sssssaud/classroom-ecosystem/Screenshot_20260919_154007.png

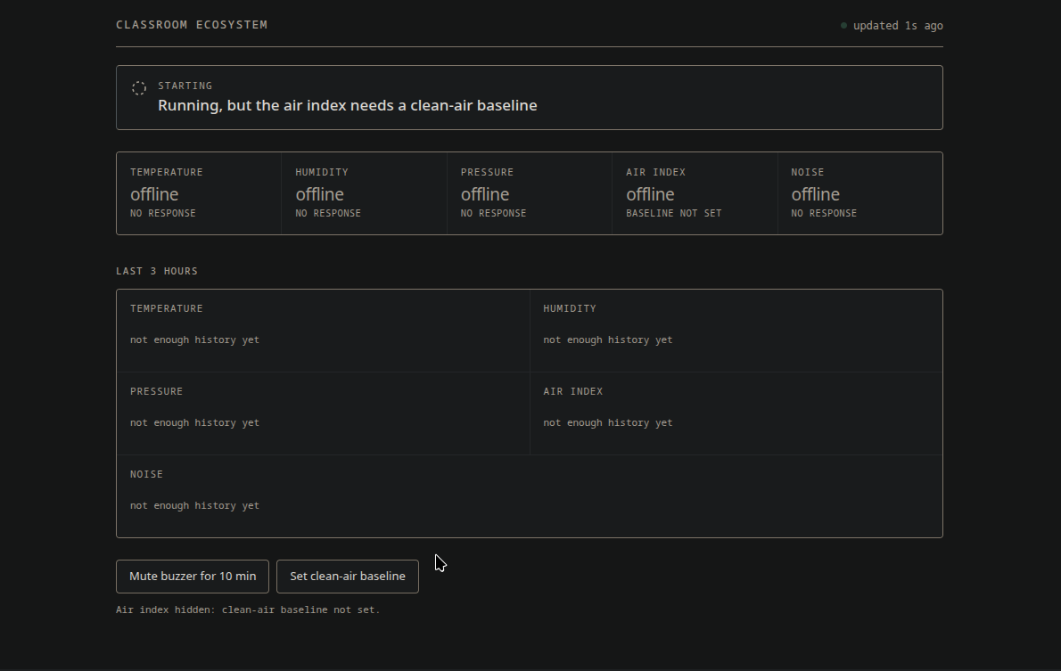
Screenshot_20260919_154007.png
