sssssaud/classroom-ecosystem/firmware/classroom_node/sensors.cpp

#include "sensors.h"

#include <Arduino.h>
#include <Wire.h>
#include <Preferences.h>
#include <Adafruit_BME280.h>
#include <Adafruit_BMP280.h>
#include <ESP_I2S.h>
#include <math.h>

#include "config.h"

namespace {

Adafruit_BME280 bme;
bool bme_ok = false;

Adafruit_BMP280 bmp;   // same footprint and addresses, no humidity die
bool bmp_ok = false;

I2SClass i2s;
bool i2s_ok = false;

Preferences prefs;
float r0_ = 0.0f;              // clean-air resistance; 0 means "never calibrated"
float rs_ema_ = 0.0f;
bool  rs_primed_ = false;

uint32_t cal_until_ms_ = 0;
double   cal_sum_ = 0.0;
uint32_t cal_n_ = 0;

// Raw sensor resistance from one ADC read, before any compensation.
// Returns 0 on an implausible reading so the caller can mark the channel dead.
float readRs() {
  const int adc = analogRead(PIN_MQ135_AO);
  const float v_node = (float(adc) / ADC_MAX) * ADC_REF_V;
  const float v_ao = v_node * (MQ_DIVIDER_R1 + MQ_DIVIDER_R2) / MQ_DIVIDER_R2;
  // At the rails the divider maths blows up (or goes negative), and a floating
  // ADC pin sits near 0. Either way we have no usable resistance.
  if (v_ao < 0.05f || v_ao >= MQ_VCC - 0.05f) return 0.0f;
  return MQ_LOAD_R * (MQ_VCC - v_ao) / v_ao;
}

// MQ sensors read lower when warm and humid. First-order correction only.
float compensate(float rs, const Reading& temp, const Reading& hum) {
  float k = 1.0f;
  if (temp.valid) k += MQ_TEMP_COEFF * (temp.value - 20.0f);
  if (hum.valid)  k += MQ_HUM_COEFF * (hum.value - 50.0f);
  if (k < 0.2f) k = 0.2f;   // never let the correction invert the reading
  return rs / k;
}

bool readNoiseDb(float& db) {
  if (!i2s_ok) return false;

  static int32_t buf[I2S_FRAMES];
  const size_t want = sizeof(buf);
  const size_t got = i2s.readBytes(reinterpret_cast<char*>(buf), want);
  const size_t n = got / sizeof(int32_t);
  if (n < 32) return false;

  // INMP441 sends 24-bit samples left-aligned in a 32-bit slot, with a DC
  // offset that would otherwise dominate the RMS.
  double sum = 0.0;
  for (size_t i = 0; i < n; ++i) sum += double(buf[i] >> 8);
  const double mean = sum / double(n);

  double sq = 0.0;
  for (size_t i = 0; i < n; ++i) {
    const double s = double(buf[i] >> 8) - mean;
    sq += s * s;
  }
  const double rms = sqrt(sq / double(n));
  // Perfect digital silence means the mic is not clocking data at all, which
  // in practice means it is unwired. Reporting a dB number for that invents one.
  if (rms < 1.0) return false;

  db = float(20.0 * log10(rms / 8388608.0)) + NOISE_DB_OFFSET;
  return true;
}

}  // namespace

// True if anything at all answers on this pin order.
static bool busHasDevices(int sda, int scl) {
  Wire.end();
  Wire.begin(sda, scl);
  Wire.setClock(100000);          // long dupont wires are marginal at 400 kHz
  for (uint8_t a = 1; a < 127; ++a) {
    Wire.beginTransmission(a);
    if (Wire.endTransmission() == 0) return true;
  }
  return false;
}

bool sensorsBegin() {
  // SDA/SCL are easy to cross on a breadboard, and a crossed pair looks exactly
  // like a dead sensor. Try the wired order, then the other one.
  if (!busHasDevices(PIN_I2C_SDA, PIN_I2C_SCL)) {
    if (busHasDevices(PIN_I2C_SCL, PIN_I2C_SDA)) {
      Serial.println("I2C: nothing on the wired order, using SDA/SCL swapped");
    } else {
      Wire.end();
      Wire.begin(PIN_I2C_SDA, PIN_I2C_SCL);
    }
  }

  // Print whatever is actually on the bus. "Not found" on its own cannot tell
  // a miswired sensor from one sitting at an address we never tried.
  Serial.print("I2C scan:");
  uint8_t seen = 0;
  for (uint8_t addr = 1; addr < 127; ++addr) {
    Wire.beginTransmission(addr);
    if (Wire.endTransmission() == 0) {
      Serial.printf(" 0x%02X", addr);
      ++seen;
    }
  }
  Serial.println(seen ? "" : " nothing responded (check SDA/SCL/VCC/GND)");

  // Breakouts ship on either address; probe both rather than make the user care.
  bme_ok = bme.begin(0x76, &Wire) || bme.begin(0x77, &Wire);
  if (bme_ok) {
    bme.setSampling(Adafruit_BME280::MODE_FORCED,
                    Adafruit_BME280::SAMPLING_X1,   // temperature
                    Adafruit_BME280::SAMPLING_X1,   // pressure
                    Adafruit_BME280::SAMPLING_X1,   // humidity
                    Adafruit_BME280::FILTER_OFF);
    Serial.println("BME280 found: temperature, humidity and pressure are real");
  } else {
    // Boards sold as "BME280" are very often BMP280: same footprint, same
    // addresses, no humidity die inside. Use it for what it does have.
    bmp_ok = bmp.begin(0x76, BMP280_CHIPID) || bmp.begin(0x77, BMP280_CHIPID);
    if (bmp_ok) {
      bmp.setSampling(Adafruit_BMP280::MODE_FORCED,
                      Adafruit_BMP280::SAMPLING_X1,   // temperature
                      Adafruit_BMP280::SAMPLING_X1,   // pressure
                      Adafruit_BMP280::FILTER_OFF);
      Serial.println("BMP280 found: temperature and pressure real, NO humidity sensor");
    } else {
      Serial.println("No BME/BMP280 on the bus: comfort channel is simulated");
    }
  }

  analogSetPinAttenuation(PIN_MQ135_AO, ADC_11db);

  // Which slot the INMP441 speaks on depends on how its L/R pin is strapped,
  // and a mismatch reads as perfect silence rather than as an error. Test both
  // slots and pick the one with real audio signal (RMS > 1.0).
  i2s_ok = false;
  double best_rms = 0.0;
  i2s_std_slot_mask_t best_slot = I2S_STD_SLOT_RIGHT;

  for (uint8_t attempt = 0; attempt < 2; ++attempt) {
    // Probe RIGHT first since L/R is tied high on this build, then LEFT
    const i2s_std_slot_mask_t slot = (attempt == 0) ? I2S_STD_SLOT_RIGHT : I2S_STD_SLOT_LEFT;
    i2s.end();
    delay(30);
    i2s.setPins(PIN_I2S_BCLK, PIN_I2S_WS, -1, PIN_I2S_DIN, -1);
    if (!i2s.begin(I2S_MODE_STD, I2S_SAMPLE_RATE, I2S_DATA_BIT_WIDTH_32BIT,
                   I2S_SLOT_MODE_MONO, slot)) {
      continue;
    }
    static int32_t probe[256];
    i2s.readBytes(reinterpret_cast<char*>(probe), sizeof(probe));   // flush/settle
    delay(30);
    const size_t n = i2s.readBytes(reinterpret_cast<char*>(probe), sizeof(probe))
                     / sizeof(int32_t);
    if (n < 32) continue;

    double sum = 0.0;
    for (size_t i = 0; i < n; ++i) sum += double(probe[i] >> 8);
    const double mean = sum / double(n);

    double sq = 0.0;
    for (size_t i = 0; i < n; ++i) {
      const double s = double(probe[i] >> 8) - mean;
      sq += s * s;
    }
    const double rms = sqrt(sq / double(n));
    if (rms > best_rms) {
      best_rms = rms;
      best_slot = slot;
    }
  }

  if (best_rms >= 1.0) {
    i2s.end();
    delay(30);
    i2s.setPins(PIN_I2S_BCLK, PIN_I2S_WS, -1, PIN_I2S_DIN, -1);
    i2s.begin(I2S_MODE_STD, I2S_SAMPLE_RATE, I2S_DATA_BIT_WIDTH_32BIT,
              I2S_SLOT_MODE_MONO, best_slot);
    i2s_ok = true;
    Serial.printf("I2S: mic found on %s slot (rms=%.1f)\n",
                  (best_slot == I2S_STD_SLOT_RIGHT) ? "RIGHT" : "LEFT", best_rms);
  } else {
    i2s.end();
    Serial.println("I2S: no mic data on either slot (check SD/GPIO33)");
  }

  prefs.begin("classroom", false);
  r0_ = prefs.getFloat("mq_r0", 0.0f);

  return bme_ok;
}

// Two periods that do not divide each other, so the trace drifts like a room
// rather than tracing a textbook sine wave.
static float drift(uint32_t now_ms, float centre, float span,
                   uint32_t period_s, uint32_t phase_s) {
  const float w = 2.0f * 3.14159265f / (float(period_s) * 1000.0f);
  const float t = float(now_ms) + float(phase_s) * 1000.0f;
  return centre + span * (0.72f * sinf(w * t) + 0.28f * sinf(w * t * 4.3f));
}

// Which channels carry synthetic values. Humidity needs the BME280's extra
// die, so a BMP280 can never supply it however well it is wired.
bool channelSimulated(ReadingId id) {
  if (id == R_HUM) return !bme_ok;
  if (id == R_TEMP || id == R_PRESS) return !bme_ok && !bmp_ok;
  return false;
}

bool anySimulated() { return !bme_ok; }

void sensorsRead(Readings& out, uint32_t now_ms) {
  // ---- BME280 ----
  if (bme_ok) {
    if (bme.takeForcedMeasurement()) {
      const float t = bme.readTemperature();
      const float h = bme.readHumidity();
      const float p = bme.readPressure() / 100.0f;
      // A disconnected BME280 reads back as NaN rather than failing loudly.
      out.v[R_TEMP]  = { t, !isnan(t) };
      out.v[R_HUM]   = { h, !isnan(h) };
      out.v[R_PRESS] = { p, !isnan(p) && p > 300.0f && p < 1100.0f };
    }
  } else if (bmp_ok) {
    if (bmp.takeForcedMeasurement()) {
      const float t = bmp.readTemperature();
      const float p = bmp.readPressure() / 100.0f;
      out.v[R_TEMP]  = { t, !isnan(t) };
      out.v[R_PRESS] = { p, !isnan(p) && p > 300.0f && p < 1100.0f };
    }
    // This chip has no humidity die, so that one channel stays synthetic.
    // channelSimulated() labels it all the way to the dashboard.
    out.v[R_HUM] = { drift(now_ms, 52.0f, 7.0f, 660, 90), true };
  } else {
    // Nothing answered on the bus, so the comfort channel runs on plausible
    // synthetic values instead of three dead tiles. Every path out of here
    // labels them, and the branch disappears when a real sensor answers at boot.
    out.v[R_TEMP]  = { drift(now_ms,   26.0f, 1.6f,  420,   0), true };
    out.v[R_HUM]   = { drift(now_ms,   52.0f, 7.0f,  660,  90), true };
    out.v[R_PRESS] = { drift(now_ms, 1011.0f, 2.2f, 1380, 200), true };
  }

  // ---- MQ-135 ----
  const float rs_raw = readRs();
  if (rs_raw > 0.0f) {
    const float rs = compensate(rs_raw, out.v[R_TEMP], out.v[R_HUM]);
    rs_ema_ = rs_primed_ ? (MQ_EMA_ALPHA * rs + (1.0f - MQ_EMA_ALPHA) * rs_ema_) : rs;
    rs_primed_ = true;

    if (calibrating(now_ms)) {
      cal_sum_ += rs;
      ++cal_n_;
    } else if (cal_n_ > 0) {                 // window just closed
      r0_ = float(cal_sum_ / double(cal_n_));
      Serial.printf("MQ: baseline closed, n=%u r0=%.0f\n", cal_n_, r0_);
      prefs.putFloat("mq_r0", r0_);
      cal_sum_ = 0.0;
      cal_n_ = 0;
    }

    // Index is R0/Rs: resistance falls as gas rises, so the number rises with
    // gas. 1.0 means "same as the clean air you calibrated in".
    // The sensor is not burned in: its clean-air resistance wanders several-fold
    // over hours. Let the baseline creep after it (tau ~20 min) so slow drift
    // never trips the alarm, while a gas puff -- seconds, not hours -- still does.
    // Not persisted: NVS would not survive a write every sample.
    if (r0_ > 0.0f && !calibrating(now_ms)) r0_ += (rs_ema_ - r0_) * MQ_R0_CREEP;

    if (r0_ > 0.0f && rs_ema_ > 0.0f) {
      out.v[R_AIR] = { r0_ / rs_ema_, true };
    }
  }

  // ---- INMP441 ----
  float db = 0.0f;
  if (readNoiseDb(db)) out.v[R_NOISE] = { db, true };
}

bool  baselineSet()  { return r0_ > 0.0f; }
// Raw baseline numbers on the API so the index can be debugged without serial.
float mqR0()         { return r0_; }
float mqRsEma()      { return rs_ema_; }
float baselineR0()   { return r0_; }

void startCalibration(uint32_t now_ms) {
  cal_until_ms_ = now_ms + CALIBRATE_MS;
  cal_sum_ = 0.0;
  cal_n_ = 0;
}

bool calibrating(uint32_t now_ms) {
  return int32_t(cal_until_ms_ - now_ms) > 0;
}

void clearBaseline() {
  r0_ = 0.0f;
  prefs.remove("mq_r0");
}
