sssssaud/classroom-ecosystem/firmware/classroom_node/sensors.h

// Hardware reads. Everything Arduino-specific lives behind this interface so
// status.cpp / history.cpp stay testable on the laptop.
#pragma once
#include <stdint.h>
#include "status.h"

// false means the BME280 never answered on either address; the node still runs
// and reports that channel offline rather than refusing to boot.
bool sensorsBegin();

// Fills every channel. Any sensor that fails sets valid=false — never 0.
void sensorsRead(Readings& out, uint32_t now_ms);

// True when this channel carries a synthetic value rather than a measurement.
// Callers must label it. A BMP280 supplies temperature and pressure but has no
// humidity die, so humidity stays synthetic even when that sensor is healthy.
bool channelSimulated(ReadingId id);
bool anySimulated();

// ---- MQ-135 clean-air baseline ----
bool  baselineSet();
float mqR0();
float mqRsEma();
float baselineR0();
void  startCalibration(uint32_t now_ms);
bool  calibrating(uint32_t now_ms);
void  clearBaseline();
