sssssaud/classroom-ecosystem/(commit log)

2026-09-19 Design spec and verified dashboard for the classroom monitor
    One ESP32 serving its own dashboard for a single classroom: BME280, MQ-135
    and INMP441 in, three status LEDs and a buzzer out.
    The dashboard is built and checked against a stdlib mock of the firmware's
    JSON, so the UI was settled with no hardware attached. No CDN and no chart
    library, because the ESP32 serves this page with no internet available.
    Two things the design refuses to fake: the MQ-135 reports a relative index
    against a user-set clean-air baseline rather than invented ppm, and a sensor
    that cannot be read renders as "offline" rather than as zero.
2026-09-19 Add ESP32 firmware: sensors, status engine, history, web server
    Sketch builds with arduino-cli for esp32:esp32:esp32 (81% flash, 19% RAM).
    - status/history stay pure C++ so they unit-test on the laptop; 10 host
    tests cover dwell, hysteresis release, mute, fault precedence and ring
    wrap (firmware/test/test_status.cpp).
    - sensors.cpp probes the BME280 at both addresses, derives the MQ-135
    index from a stored clean-air baseline, and reads the INMP441 over I2S.
    A dead channel reports invalid, never 0.
    - The dashboard is embedded from ui/index.html via tools/gen_page.py, so
    there is one source of truth for the UI.
    - Falls back to a SoftAP when the room WiFi is absent.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
2026-09-19 Make the LEDs match the agreed signalling
    - Green blinks at 1 Hz while the room is normal and goes dark the instant
    it is not, so "normal" is an active signal rather than an ambiguous
    steady lamp.
    - Blue stays on whenever the node has power.
    - Red uses a two-pulse alarm cadence on a gas alert, distinct from green's
    calm heartbeat, and the buzzer rides the same pulses.
    Red is now reserved for gas, so a sensor fault shows as green-off only;
    the dashboard still names the failed channel.
    [classroom_node.ino]
2026-09-19 Add I2C scan, SoftAP mDNS and HTTP request logging
    "BME280 not found" could not distinguish a miswired sensor from one at an
    untried address, so boot now prints every address that answers on the bus.
    mDNS started only after a successful STA join, so classroom.local never
    resolved on the SoftAP — the one mode where a typed IP is most error-prone.
    It now starts in both modes.
    Requests are logged so "the page will not load" can be told apart from
    "the phone never reached the board".
    [classroom_node.ino, sensors.cpp]
2026-09-19 Report an unwired microphone as offline, not as -38 dB
    A disconnected INMP441 clocks out pure digital silence. The silence floor
    turned that into a real-looking reading that the dashboard showed as "ok",
    which is exactly the fabricated number the rest of the design avoids.
    Verified against the board: noise_db now returns null/offline.
    [sensors.cpp]
2026-09-19 firmware: find the INMP441 on whichever I2S slot it actually speaks on
    The mic was wired with L/R strapped high, so it transmits in the RIGHT
    slot while the driver only ever opened LEFT. A slot mismatch reads back
    as perfect digital silence, not as an error, so it looked like dead
    hardware. Probe both slots at boot and keep the one carrying samples.
    Measured a quiet room at -67 dBFS, so NOISE_DB_OFFSET moves 100 -> 107
    to put that near 40 dB SPL. Still a fudge factor; tune against a phone
    SPL meter.
    Adds firmware/diagnose, the per-device bring-up sketch that found this:
    I2C scan on both pin orders, raw ADC, I2S, LEDs and buzzer one at a time.
    CLAUDE.md still claimed PlatformIO and a firmw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
    [config.h, diagnose.ino, sensors.cpp]
2026-09-19 firmware: run the comfort channel on labelled simulated data until a BME280 is fitted
    No BME280 answers anywhere on the bus, and the build has to ship, so
    sensorsRead synthesizes temperature, humidity and pressure rather than
    leaving three permanently dead tiles.
    These are not measurements and nothing pretends otherwise: the tiles carry
    "simulated - no BME280 fitted", the status line reads "Demo mode", and
    bmeSimulated() is the single switch behind both. A classroom safety display
    that quietly invents a temperature is worse than one that admits it has no
    sensor. The whole branch is skipped as soon as a real BME280 answers at boot.
    Verified on hardware: all five readings live, history strea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
    [classroom_node.ino, sensors.cpp, sensors.h]
2026-09-19 firmware: the comfort sensor is a BMP280 on crossed I2C pins, not a missing BME280
    Testing the board on its own finally showed it: nothing answers on the wired
    SDA/SCL order, but 0x76 answers on the swapped one, reporting chip ID 0x58.
    So the part was never absent. It is a BMP280 — same footprint, same addresses,
    no humidity die — reached through a crossed pair.
    sensorsBegin now scans the wired pin order then the swapped one, and probes
    for both chips. A BMP280 supplies real temperature and pressure; humidity has
    no sensor behind it on this part, so that one channel stays synthetic and
    channelSimulated() labels it per channel rather than condemning all three.
    Drops a setup() line that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
    [classroom_node.ino, sensors.cpp, sensors.h]
2026-09-19 firmware: let the gas baseline follow an un-burned-in sensor's drift
    The node sat in a permanent gas ALERT with the buzzer running. The alert
    logic was right: the index really did exceed the threshold. The baseline
    was wrong. An MQ-135 that has not burned in moves its clean-air
    resistance several-fold over hours -- measured 2.4k, 8.5k and 13.6k on
    the same board in clean air -- so any fixed R0 goes stale within the hour
    and the index climbs past 2.5 on drift alone.
    R0 now creeps toward the smoothed reading with a ~20 min time constant.
    Hours of drift are absorbed; a gas puff lasting seconds still moves the
    index, which is the event worth alarming on. The creep is not persisted,
    since NVS wo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
    [classroom_node.ino, config.h, diagnose.ino, sensors.cpp, sensors.h]
2026-09-19 firmware: widen the comfort band to a room without air conditioning
    The node sat in WARN with the green LED dark while every reading was
    fine. The cause was the comfort band: 18-30 C is an air-conditioned
    office standard, and this room measures 30.2 C with the fans running.
    The BMP280 also sits on the board, so it reads a little high. Flagging
    that as discomfort is noise, and it masked the gas channel underneath.
    The upper limit moves to 34 C. The host tests pin temp_hi at 30
    themselves, since they exercise the state machine rather than the
    tuning, which belongs to the room.
    [classroom_node.ino, status.h]
2026-09-25 Commit pending firmware, UI and docs work
    These 12 changes were sitting uncommitted and unbacked on the laptop:
    firmware updates for the classroom node (sensors, status, page, config),
    the UI page, PROGRESS/README updates, a buzzer test sketch, the ESP32
    how-to doc and a dashboard screenshot.
    [classroom_node.ino, config.h, sensors.cpp, status.cpp]
2026-09-25 Replace pinout photo with a checked-in pin table
    docs/pinout.jpeg was a photo of a hand-drawn wiring sheet - not greppable,
    not diffable, and wrong in three places. Transcribed it to docs/pinout.md
    and reconciled every pin against config.h.
    The sheet has the MQ-135 divider resistors swapped (10k series / 20k to
    GND); the firmware is built for 20k series / 10k to GND. Building it the
    sheet's way puts ~3.3V on GPIO34 instead of ~1.67V and scales every
    air-index reading wrong. The table says so explicitly, along with the
    BMP280-not-BME280 and L/R-tied-high differences.
    [config.h]
2026-10-26 docs: describe the indicators the firmware actually drives
    The LED table predated the firmware and never matched it. Blue is solid
    whenever the box has power rather than blinking for WiFi; green is solid
    on a normal room, not blinking; red flashes a two-pulse alarm cadence on
    a gas alert rather than sitting solid; and nothing drives a red blink for
    a sensor fault. Someone wiring this up from the README would have read
    every one of those backwards.
    Also records where the thresholds live and why the comfort band is 18-34.
